WiktorKociuba/protogen-head/assets/mainBoard.png

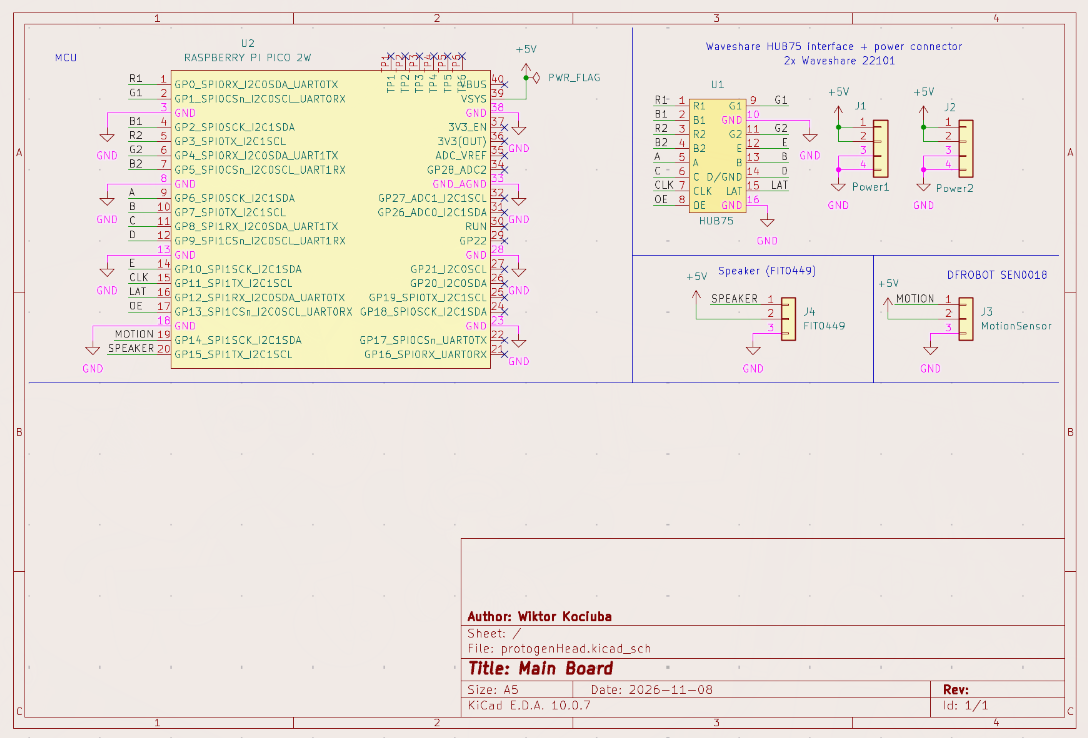
assets/mainBoard.png
