WiktorKociuba/protogen-head/hardware/protogenHead/jlcpcb/production_files/BOM-protogenHead.csv

Comment | Designator | Footprint | LCSC | Quantity
0.1u | C4,C6,C7,C8 | C_0603_1608Metric | C14663 | 4
10k | R1,R2,R3 | R_0603_1608Metric | C25804 | 3
10u | C3 | C_0603_1608Metric | C19702 | 1
1u | C1,C2,C5 | C_0603_1608Metric | C15849 | 3
22 | R4,R5 | R_0603_1608Metric | C23345 | 2
5.1k | R6,R7,R8,R9 | R_0603_1608Metric | C23186 | 4
74AHCT245PW | U5,U6 | TSSOP-20_L6.5-W4.4-P0.65-LS6.4-BL | C54815895 | 2
AP2112K-3.3 | U3 | SOT-23-5 | C23380830 | 1
AltPWR | J10 | AMASS_XT30U-F_1x02_P5.0mm_Vertical | C99102 | 1
Conn_01x01 | J12 | PinSocket_1x01_P2.54mm_Vertical | C49569624 | 1
Conn_02x08_Counter_Clockwise | J13 | PinHeader_2x08_P2.54mm_Vertical | C5383108 | 1
ESP32-S3-MINI-1 | U4 | ESP32-S2-MINI-1 | C2913206 | 1
FIT0449 | J4 | JST_EH_B3B-EH-A_1x03_P2.50mm_Vertical | C160259 | 1
Fan1 | J8 | JST_EH_B2B-EH-A_1x02_P2.50mm_Vertical | C160262 | 1
Fan2 | J9 | JST_EH_B2B-EH-A_1x02_P2.50mm_Vertical | C160262 | 1
HUB75 | U1 | IDC-Header_2x08_P2.54mm_Vertical | C2884532 | 1
Power1 | J1 | TerminalBlock_MaiXu_MX126-5.0-02P_1x02_P5.00mm | C5188434 | 1
Power2 | J2 | TerminalBlock_MaiXu_MX126-5.0-02P_1x02_P5.00mm | C5188434 | 1
PowerExt | J11 | PinHeader_2x04_P2.54mm_Vertical | C5383105 | 1
PowerSup | J7 | USB_C_Receptacle_HRO_TYPE-C-31-M-12 | C165948 | 1
PowerSup+Data | J3 | USB_C_Receptacle_HRO_TYPE-C-31-M-12 | C165948 | 1
TS-1187A-B-A-B | SW3,SW4 | SW-SMD_4P-L5.1-W5.1-P3.70-LS6.5-TL_H1.5 | C318884 | 2
WS2812B | J5,J6 | JST_EH_B3B-EH-A_1x03_P2.50mm_Vertical | C160259 | 2
