WiktorKociuba/protogen-head/hardware/protogenHead/Schematics/protogenHead-B_Cu.pdf

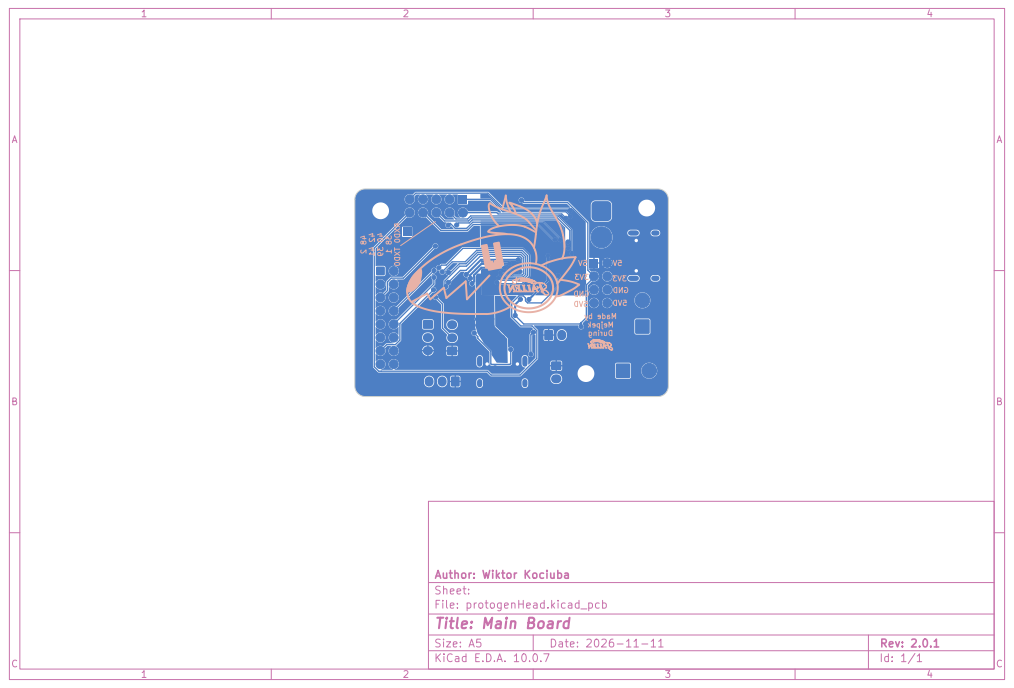
[picture p4: page 1]

Size: A5 | Rev: 2.0.1 | C Date: 2026-11-11
KiCad E.D.A. 10.0.7 | Id: 1/1
