WiktorKociuba/protogen-head/hardware/protogenHead/Schematics/protogenHead-F_Cu.pdf

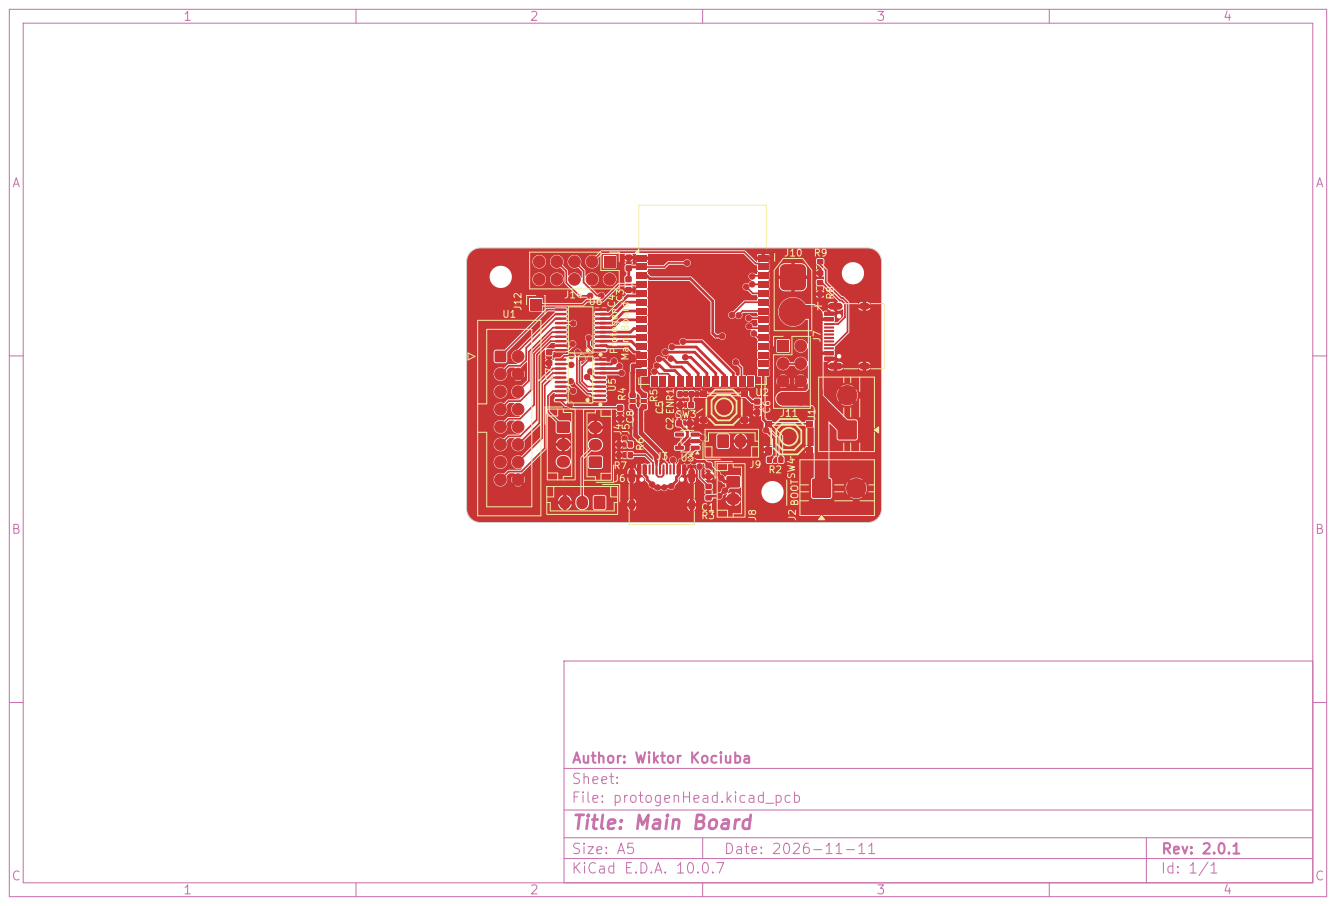
[picture p5: page 1]

Size: A5 | Rev: 2.0.1
KiCad E.D.A. 10.0.7 | Id: 1/1
