WiktorKociuba/protogen-head/hardware/protogenHead/Schematics/protogenHead.pdf

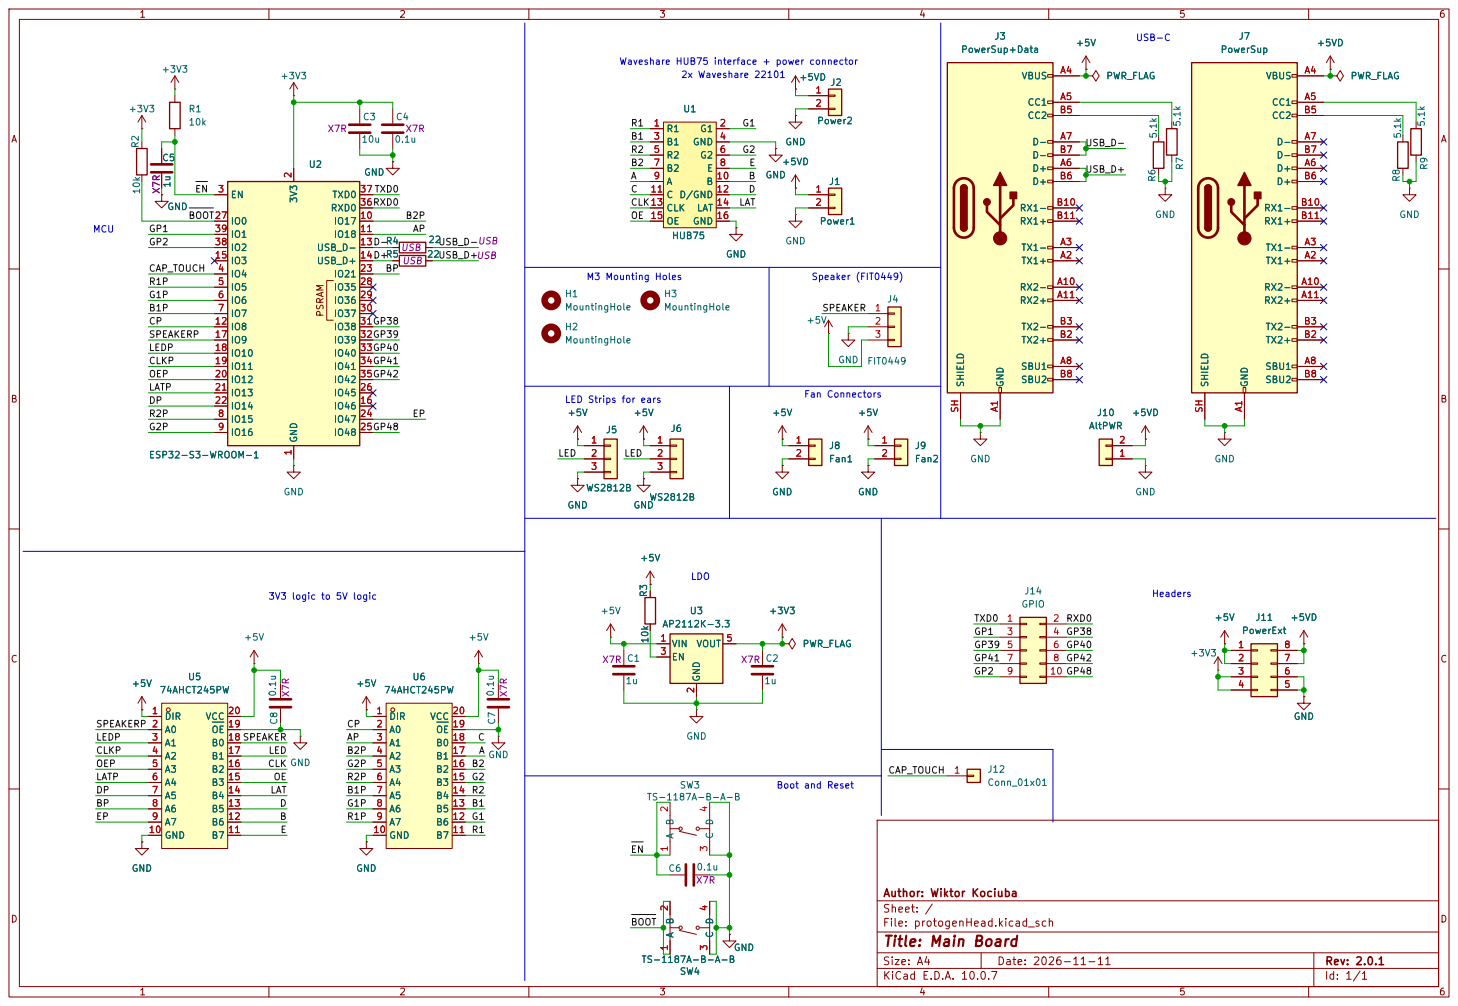
[picture p6: page 1]

Waveshare HUB75 interface + power connector 2x Waveshare 22101 MCU

Size: A4 | Rev: 2.0.1
KiCad E.D.A. 10.0.7 | Id: 1/1
