WiktorKociuba/protogen-head/hardware/backup (rpi)/protogenHead/protogenHead-Edge_Cuts.pdf

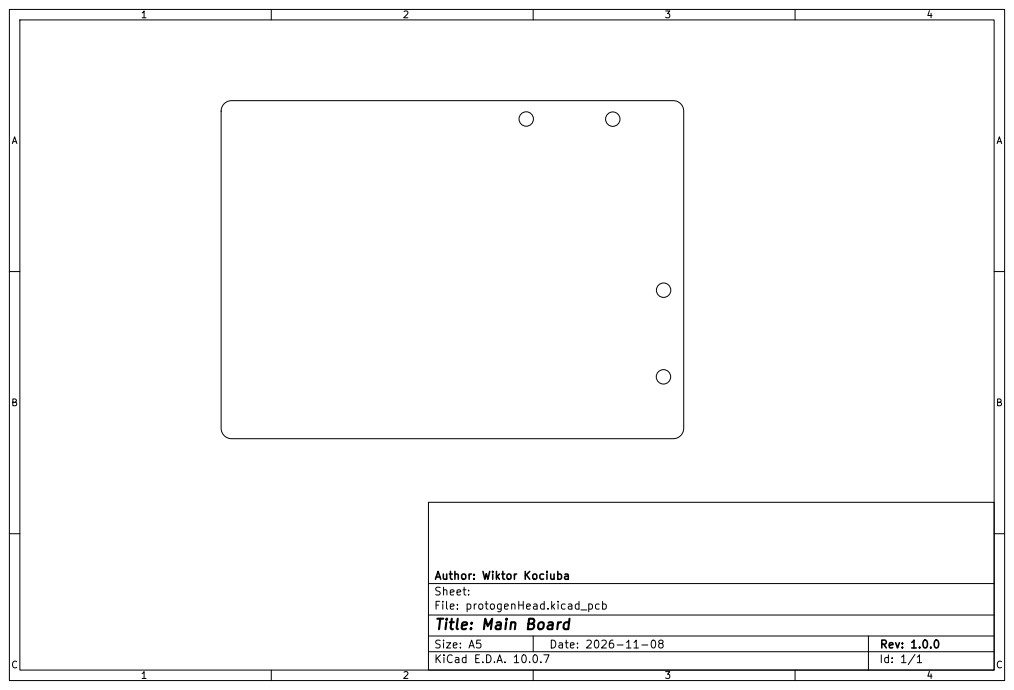
[picture p7: page 1]

Size: A5 | Rev: 1.0.0 | C Date: 2026-11-08
KiCad E.D.A. 10.0.7 | Id: 1/1
