WiktorKociuba/protogen-head/kicad/protogenHead/protogenHead.pdf

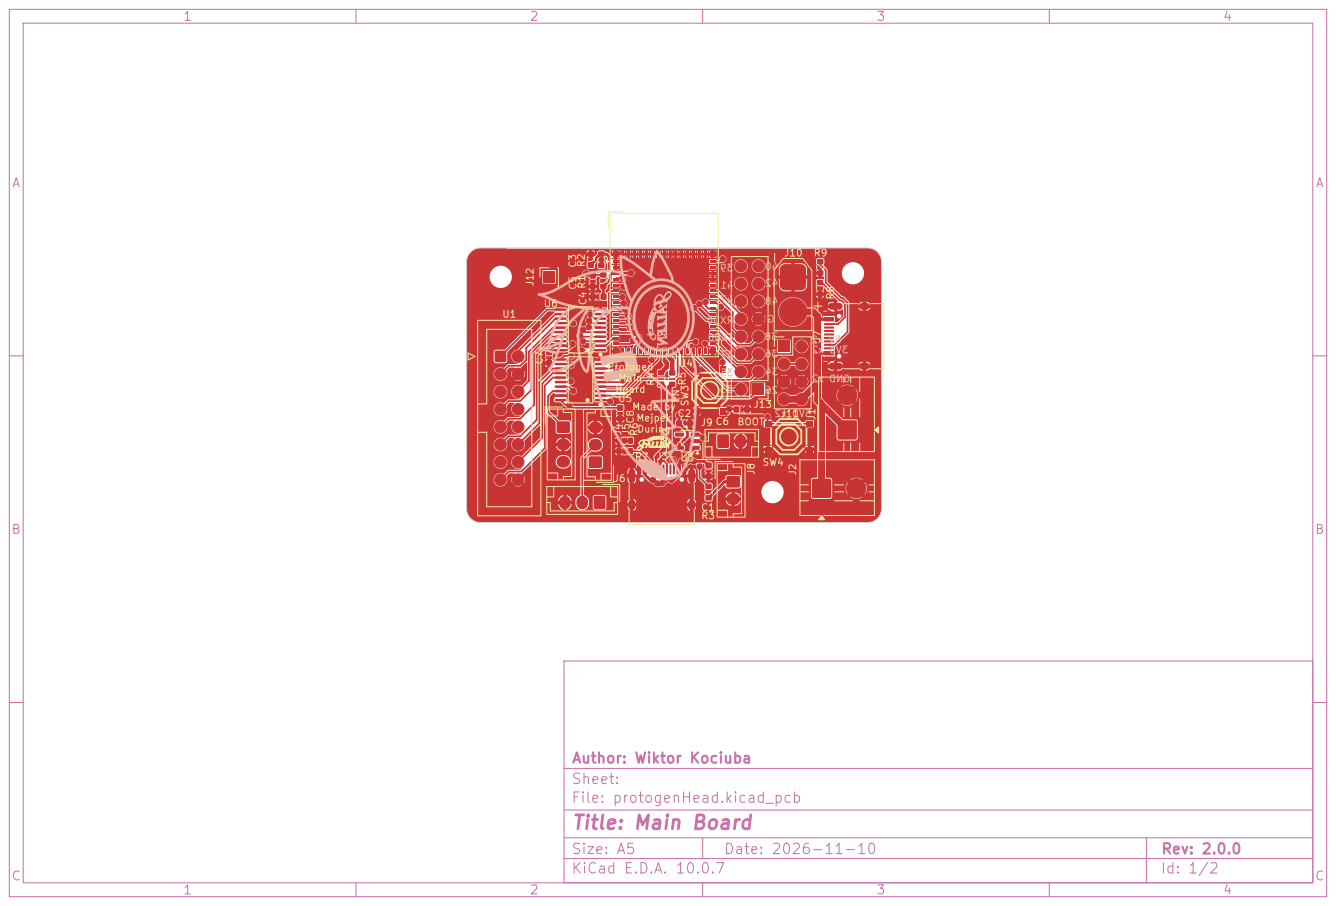
[picture p8: page 1]

Size: A5 | Rev: 2.0.0
KiCad E.D.A. 10.0.7 | Id: 1/2

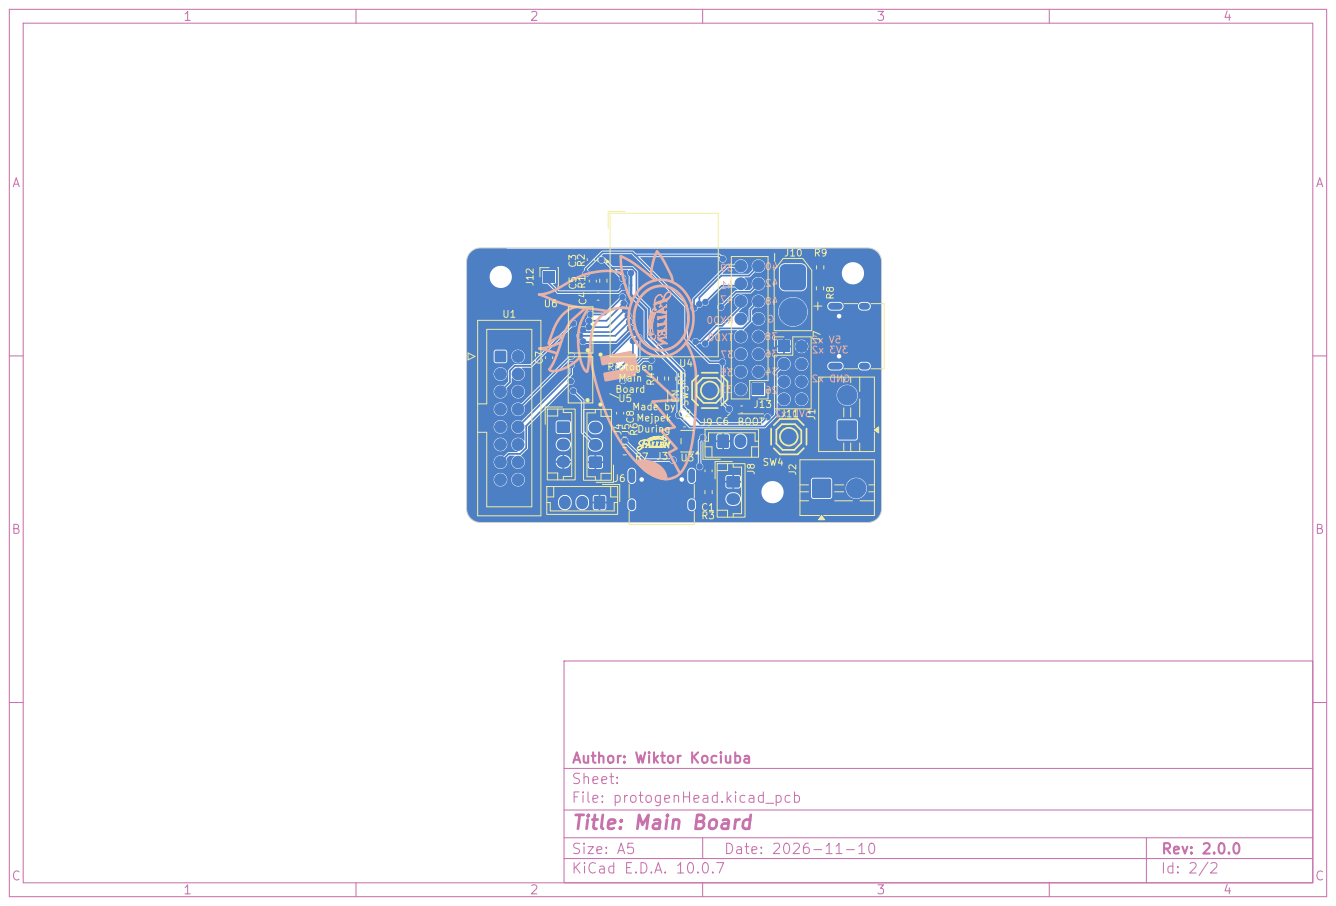
[picture p9: page 2]

Size: A5 | Rev: 2.0.0
KiCad E.D.A. 10.0.7 | Id: 2/2
