WiktorKociuba/protogen-head/kicad/protogenHead/schemat.svg/protogenHead.pdf

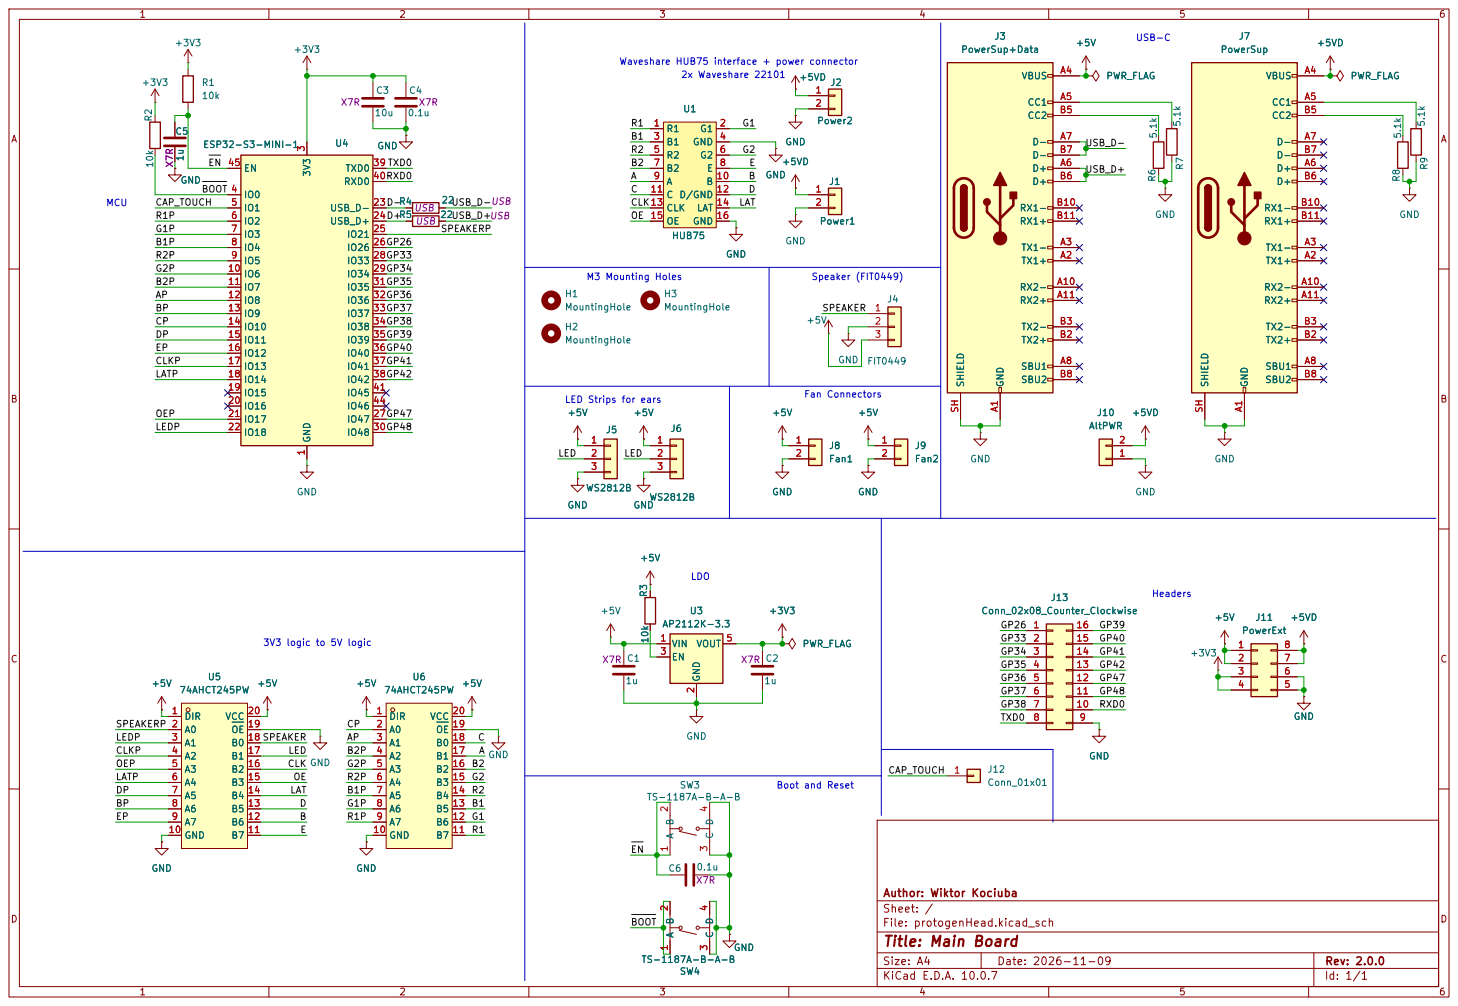
[picture p10: page 1]

Boot and Reset LDO

Size: A4 | Rev: 2.0.0
KiCad E.D.A. 10.0.7 | Id: 1/1
