WiktorKociuba/protogen-head/kicad/backup (rpi)/protogenHead/protogenHead-F_Fab.pdf

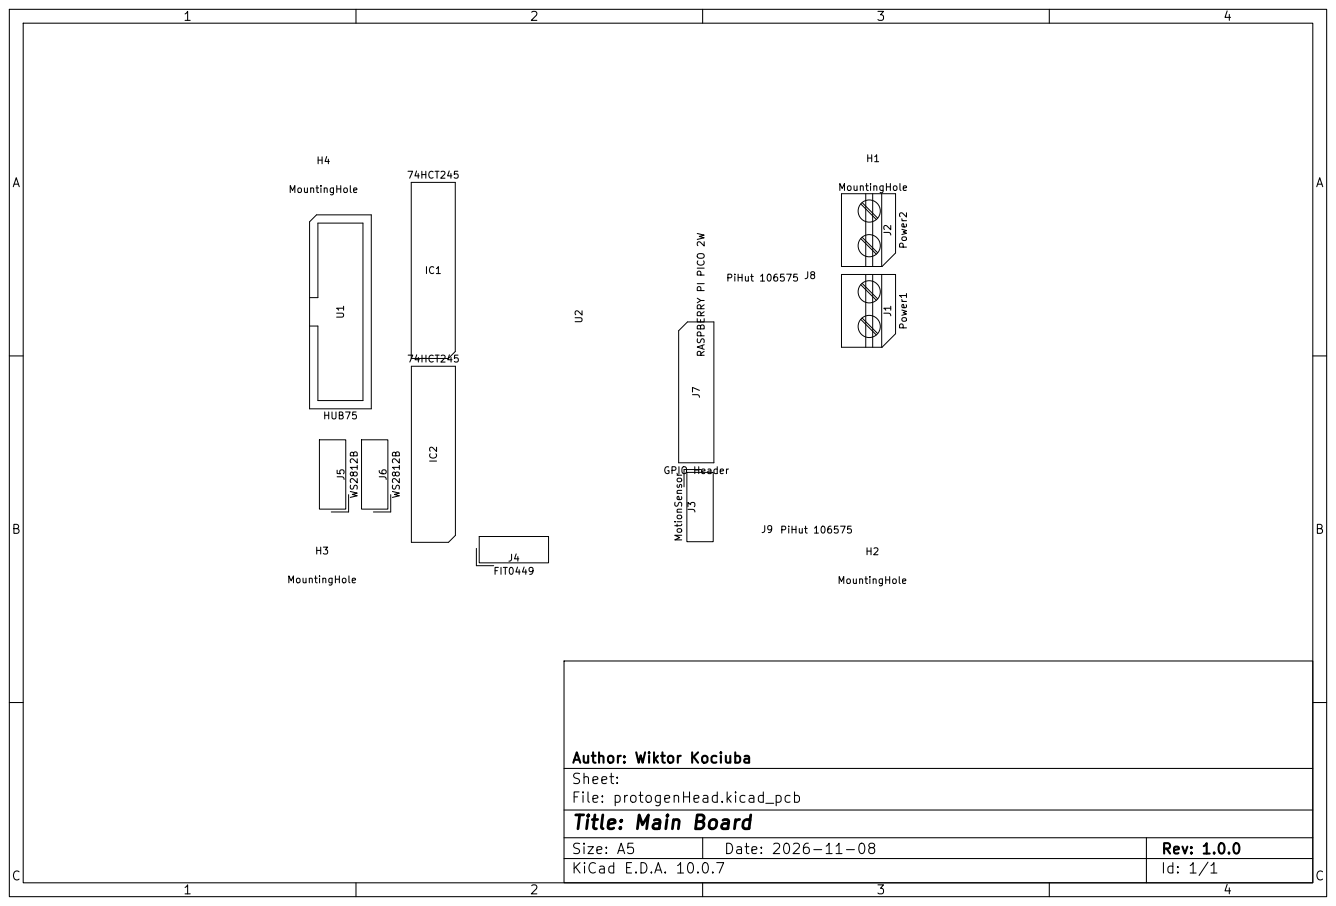
[picture p11: page 1]

Size: A5 | Rev: 1.0.0
KiCad E.D.A. 10.0.7 | Id: 1/1
