WiktorKociuba/protogen-head/hardware/backup (rpi)/protogenHead/protogenHead-B_Cu.pdf

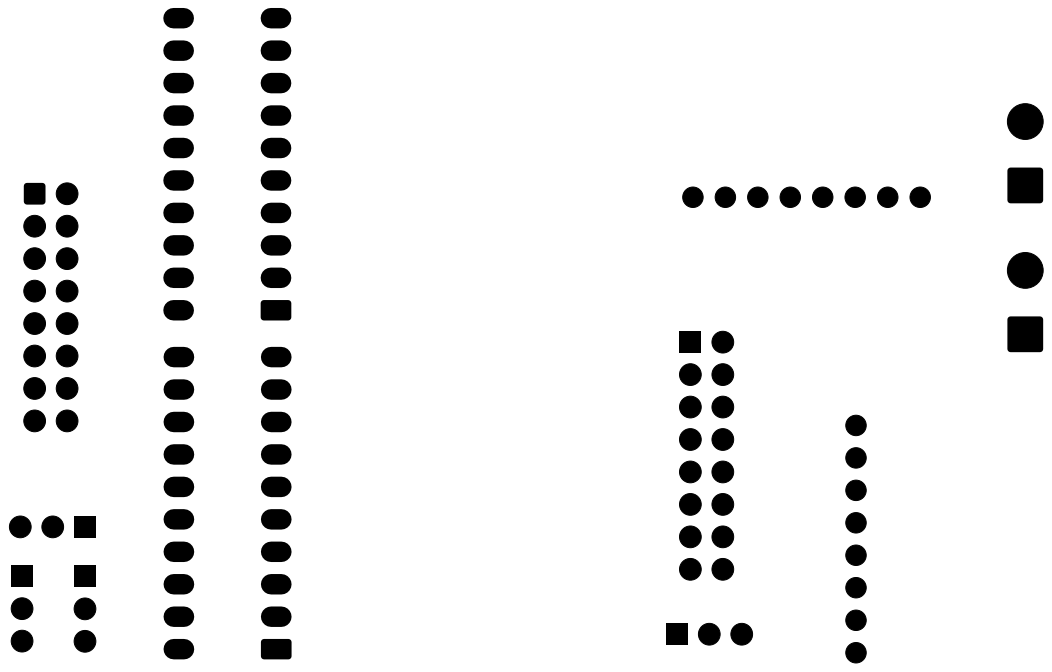
[picture p12: page 1]
