WiktorKociuba/protogen-head/hardware/backup (rpi)/protogenHead/protogenHead-F_Paste.pdf

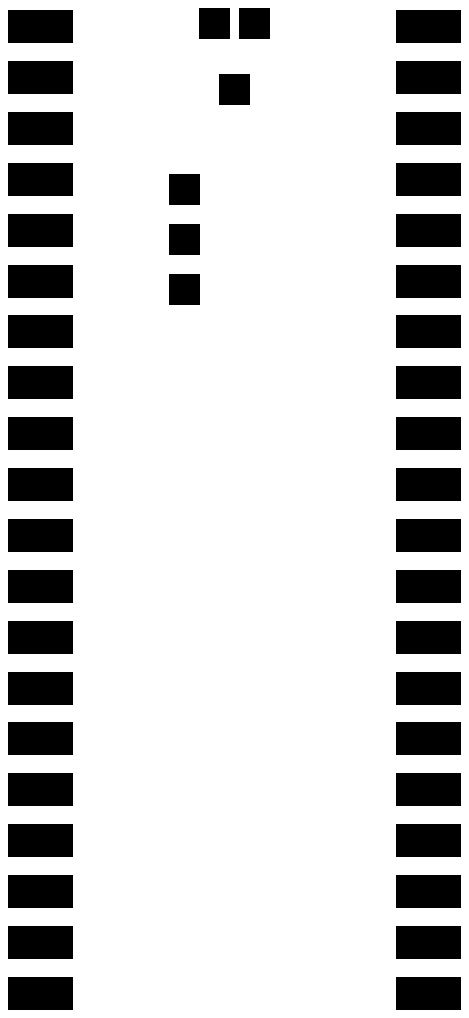
[picture p13: page 1]
