WiktorKociuba/protogen-head/kicad/backup (rpi)/protogenHead/protogenHead-B_Mask.pdf

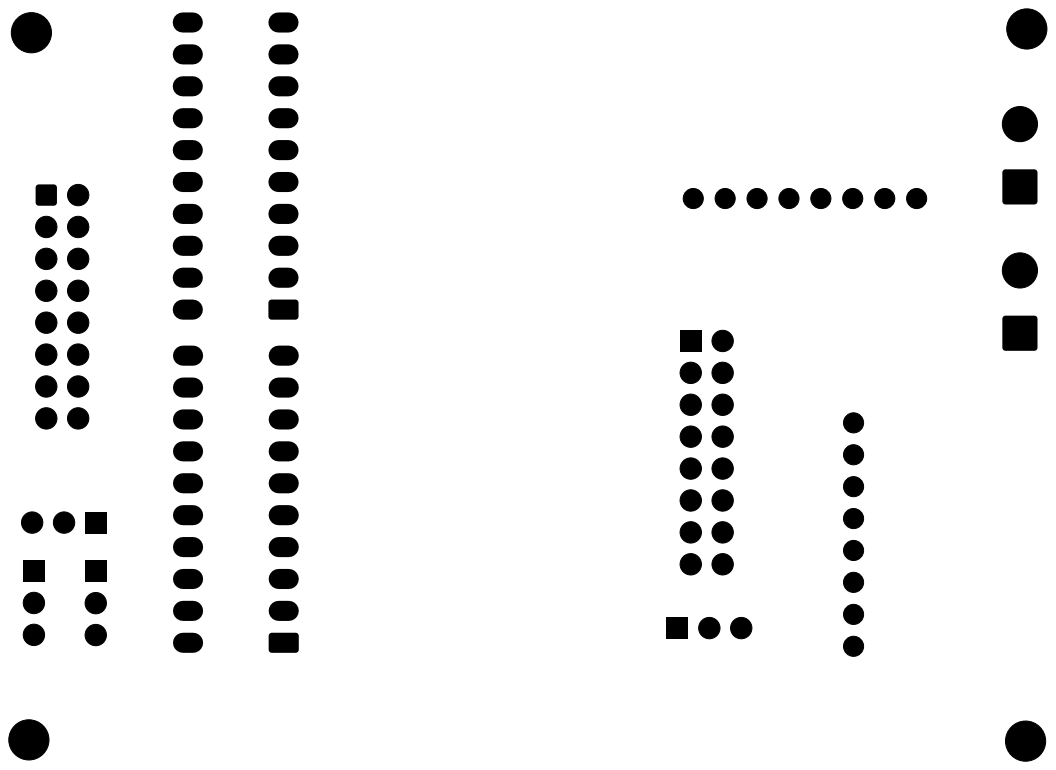
[picture p14: page 1]
