WiktorKociuba/protogen-head/kicad/backup (rpi)/protogenHead/protogenHead-F_Silkscreen.pdf

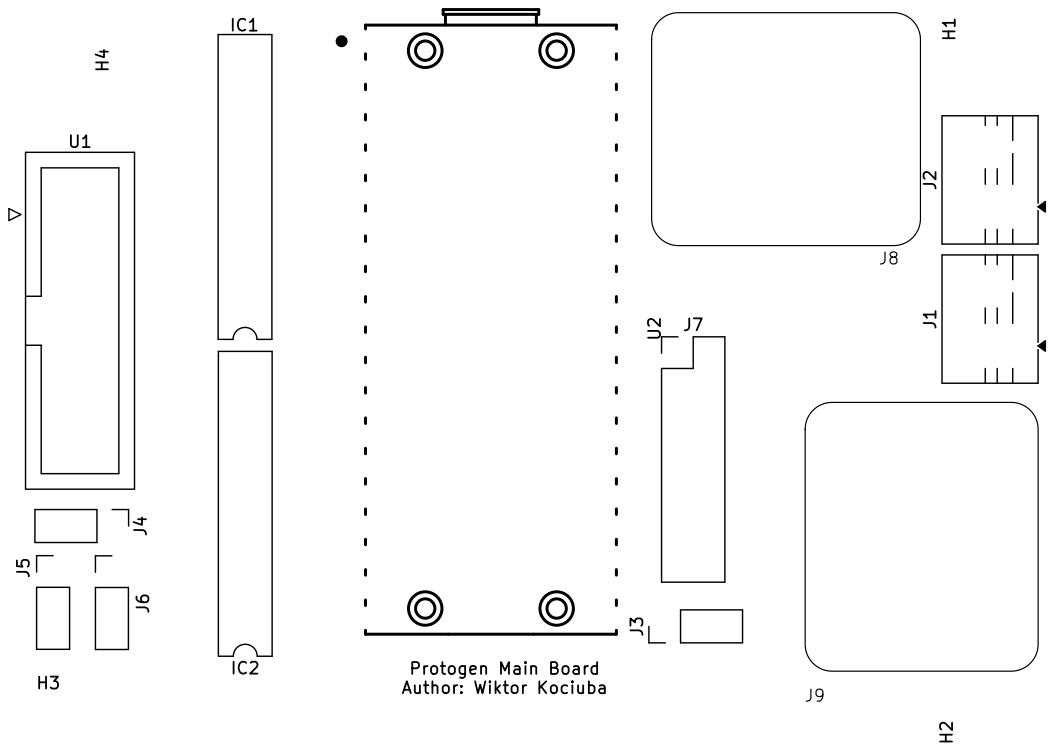
[picture p15: page 1]
