WiktorKociuba/protogen-head/hardware/protogenHead/protogenHead.kicad_pcb

## KiCad design hardware/protogenHead/protogenHead.kicad_pcb (2026-11-12)

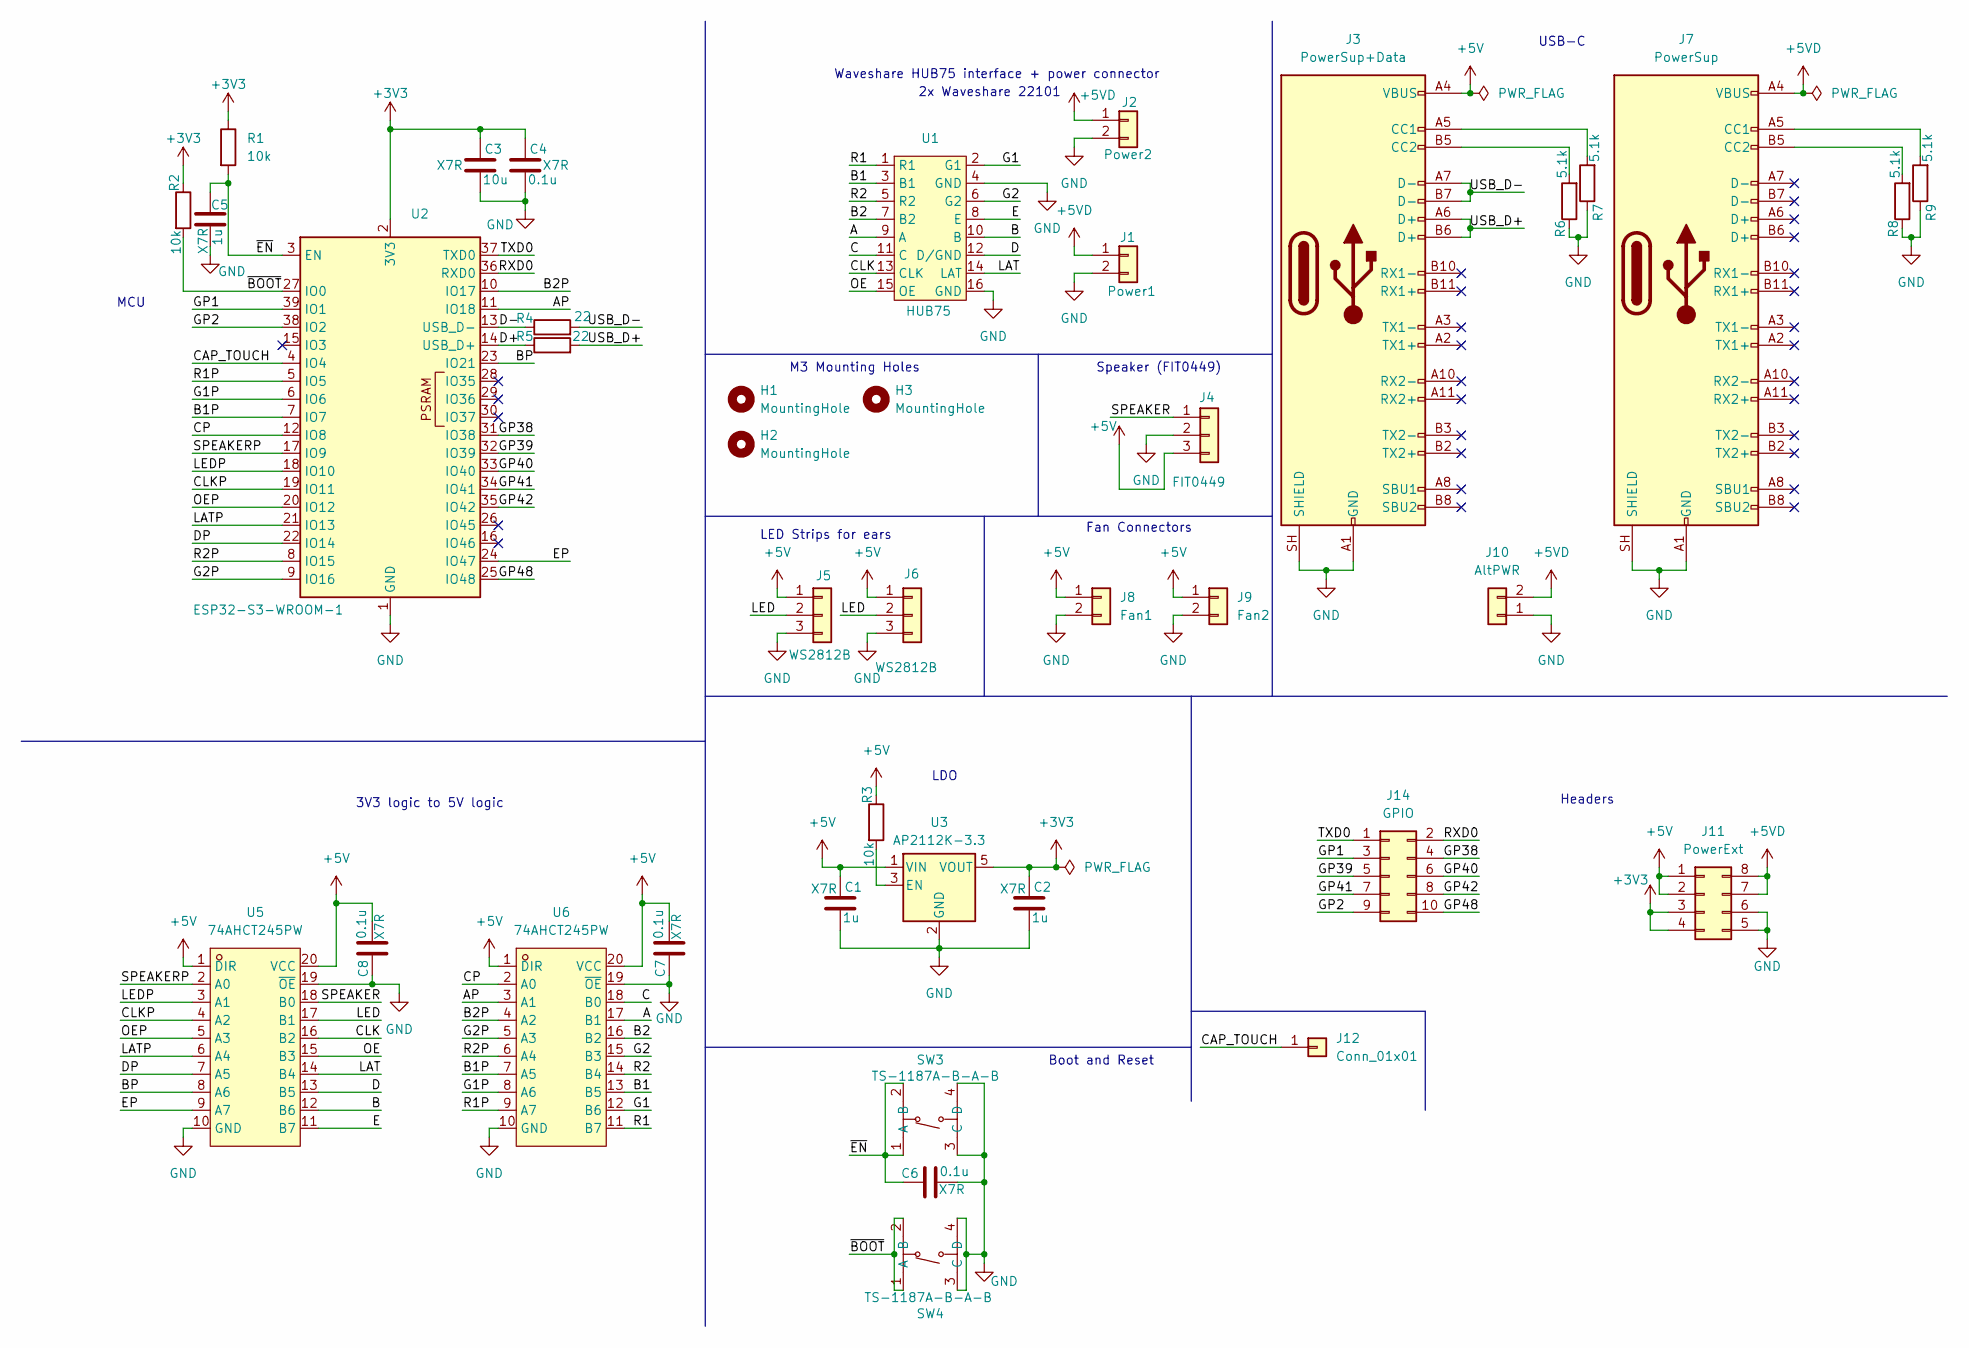
[picture p16: schematic protogenHead.kicad_sch, Main Board]

Parts:
C1, C2, C5: 1u; C_0603_1608Metric
C3: 10u; C_0603_1608Metric
C4, C6, C7, C8: 0.1u; C_0603_1608Metric
H1, H2, H3: MountingHole; MountingHole_3.2mm_M3
J1: Power1; TerminalBlock_MaiXu_MX126-5.0-02P_1x02_P5.00mm
J2: Power2; TerminalBlock_MaiXu_MX126-5.0-02P_1x02_P5.00mm
J3: PowerSup+Data; USB_C_Receptacle_HRO_TYPE-C-31-M-12
J4: FIT0449; JST_EH_B3B-EH-A_1x03_P2.50mm_Vertical
J5, J6: WS2812B; JST_EH_B3B-EH-A_1x03_P2.50mm_Vertical
J7: PowerSup; USB_C_Receptacle_HRO_TYPE-C-31-M-12
J8: Fan1; JST_EH_B2B-EH-A_1x02_P2.50mm_Vertical
J9: Fan2; JST_EH_B2B-EH-A_1x02_P2.50mm_Vertical
J10: AltPWR; AMASS_XT30U-F_1x02_P5.0mm_Vertical
J11: PowerExt; PinHeader_2x04_P2.54mm_Vertical
J12: Conn_01x01; PinSocket_1x01_P2.54mm_Vertical
J14: GPIO; PinHeader_2x05_P2.54mm_Vertical
R1, R2, R3: 10k; R_0603_1608Metric
R4, R5: 22; R_0603_1608Metric
R6, R7, R8, R9: 5.1k; R_0603_1608Metric
SW3, SW4: TS-1187A-B-A-B; SW-SMD_4P-L5.1-W5.1-P3.70-LS6.5-TL_H1.5; MPN TS-1187A-B-A-B; LCSC Part C318884
U1: HUB75; IDC-Header_2x08_P2.54mm_Vertical
U2: ESP32-S3-WROOM-1
U3: AP2112K-3.3; SOT-23-5
U5, U6: 74AHCT245PW; TSSOP-20_L6.5-W4.4-P0.65-LS6.4-BL; MPN 74AHCT245PW; LCSC Part C54815895

Connections:
+3V3: C2.1, C3.1, C4.1, J11.3, J11.4, R1.1, R2.1, U2.2 (3V3), U3.5 (VOUT)
+5V: C1.1, C7.2, C8.2, J3.A4 (VBUS), J3.A9 (VBUS), J3.B4 (VBUS), J3.B9 (VBUS), J4.3, J5.1, J6.1, J8.1, J9.1, J11.1, J11.2, R3.1, U3.1 (VIN), U5.1 (DIR), U5.20 (VCC), U6.1 (DIR), U6.20 (VCC)
+5VD: J1.1, J2.1, J7.A4 (VBUS), J7.A9 (VBUS), J7.B4 (VBUS), J7.B9 (VBUS), J10.2, J11.7, J11.8
/A: U1.9 (A), U6.17 (B1)
/AP: U2.11 (IO18), U6.3 (A1)
/B: U1.10 (B), U5.12 (B6)
/B1: U1.3 (B1), U6.13 (B5)
/B1P: U2.7 (IO7), U6.7 (A5)
/B2: U1.7 (B2), U6.16 (B2)
/B2P: U2.10 (IO17), U6.4 (A2)
/BP: U2.23 (IO21), U5.8 (A6)
/C: U1.11 (C), U6.18 (B0)
/CAP_TOUCH: J12.1 (Pin_1_1), U2.4 (IO4)
/CLK: U1.13 (CLK), U5.16 (B2)
/CLKP: U2.19 (IO11), U5.4 (A2)
/CP: U2.12 (IO8), U6.2 (A0)
/D: U1.12 (D/GND), U5.13 (B5)
/D+: R5.1, U2.14 (USB_D+)
/D-: R4.1, U2.13 (USB_D-)
/DP: U2.22 (IO14), U5.7 (A5)
/E: U1.8 (E), U5.11 (B7)
/EP: U2.24 (IO47), U5.9 (A7)
/G1: U1.2 (G1), U6.12 (B6)
/G1P: U2.6 (IO6), U6.8 (A6)
/G2: U1.6 (G2), U6.15 (B3)
/G2P: U2.9 (IO16), U6.5 (A3)
/GP1: J14.3, U2.39 (IO1)
/GP2: J14.9, U2.38 (IO2)
/GP38: J14.4, U2.31 (IO38)
/GP39: J14.5, U2.32 (IO39)
/GP40: J14.6, U2.33 (IO40)
/GP41: J14.7, U2.34 (IO41)
/GP42: J14.8, U2.35 (IO42)
/GP48: J14.10, U2.25 (IO48)
/LAT: U1.14 (LAT), U5.14 (B4)
/LATP: U2.21 (IO13), U5.6 (A4)
/LED: J5.2, J6.2, U5.17 (B1)
/LEDP: U2.18 (IO10), U5.3 (A1)
/OE: U1.15 (OE), U5.15 (B3)
/OEP: U2.20 (IO12), U5.5 (A3)
/R1: U1.1 (R1), U6.11 (B7)
/R1P: U2.5 (IO5), U6.9 (A7)
/R2: U1.5 (R2), U6.14 (B4)
/R2P: U2.8 (IO15), U6.6 (A4)
/RXD0: J14.2, U2.36 (RXD0)
/SPEAKER: J4.1, U5.18 (B0)
/SPEAKERP: U2.17 (IO9), U5.2 (A0)
/TXD0: J14.1, U2.37 (TXD0)
/USB_D+: J3.A6 (D+), J3.B6 (D+), R5.2
/USB_D-: J3.A7 (D-), J3.B7 (D-), R4.2
/~BOOT: R2.2, SW4.1 (A), SW4.2 (B), U2.27 (IO0)
/~EN: C5.1, C6.1, R1.2, SW3.1 (A), SW3.2 (B), U2.3 (EN)
GND: C1.2, C2.2, C3.2, C4.2, C5.2, C6.2, C7.1, C8.1, J1.2, J2.2, J3.A1 (GND), J3.A12 (GND), J3.B1 (GND), J3.B12 (GND), J3.SH (SHIELD), J4.2, J5.3, J6.3, J7.A1 (GND), J7.A12 (GND), J7.B1 (GND), J7.B12 (GND), J7.SH (SHIELD), J8.2, J9.2, J10.1, J11.5, J11.6, R6.1, R7.1, R8.1, R9.1, SW3.3 (C), SW3.4 (D), SW4.3 (C), SW4.4 (D), U1.4 (GND), U1.16 (GND), U2.1 (GND), U2.40 (GND), U2.41 (GND), U3.2 (GND), U5.10 (GND), U5.19 (~OE), U6.10 (GND), U6.19 (~OE)
unnamed: J3.A5 (CC1), R7.2
unnamed: J3.B5 (CC2), R6.2
unnamed: J7.A5 (CC1), R9.2
unnamed: J7.B5 (CC2), R8.2
unnamed: R3.2, U3.3 (EN)

Notes on the sheet:
3V3 logic to 5V logic
Boot and Reset
M3 Mounting Holes
USB-C
Fan Connectors
Speaker (FIT0449)
LDO
Waveshare HUB75 interface + power connector
LED Strips for ears
2x Waveshare 22101
Headers
MCU

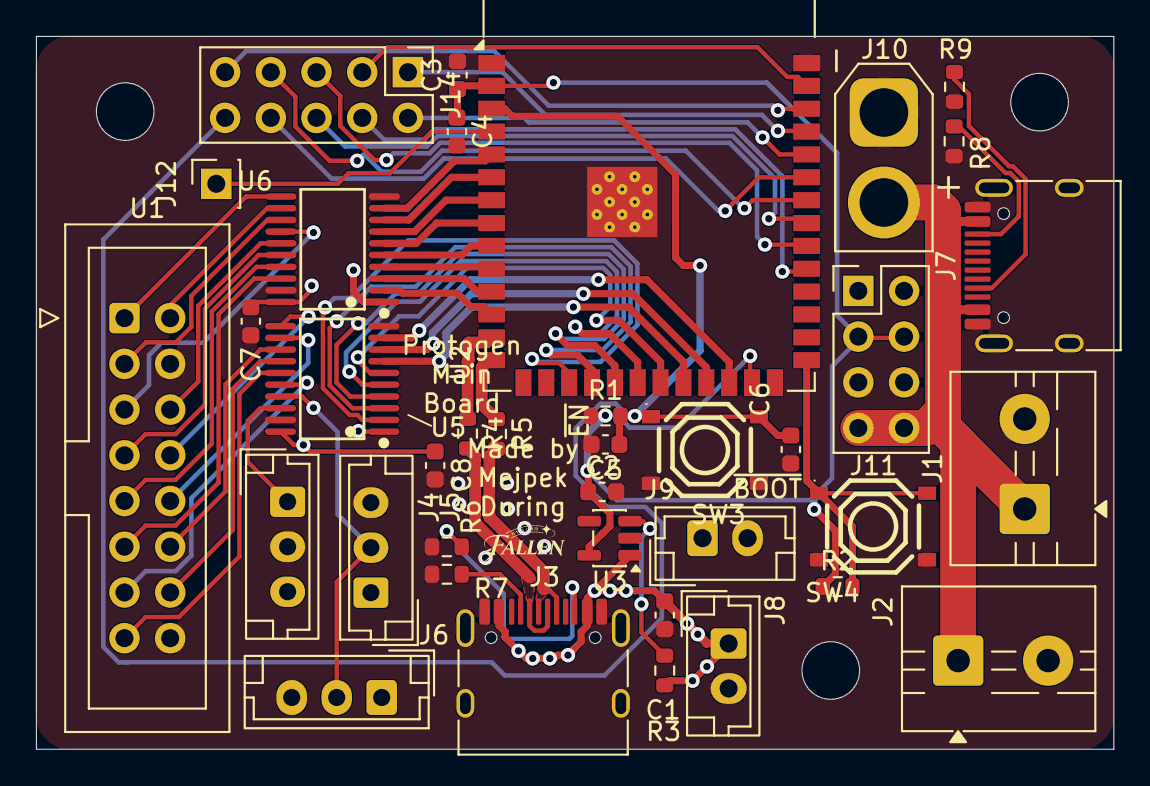
[picture p17: board hardware/protogenHead/protogenHead.kicad_pcb from above]

Board: 2 copper layers, 59.9 x 39.6 mm, 40 parts (0 on the bottom side), 58 nets.
