WiktorKociuba/protogen-head/kicad/backup (rpi)/protogenHead/protogenHead.kicad_pcb

## KiCad design kicad/backup (rpi)/protogenHead/protogenHead.kicad_pcb (2026-11-09)

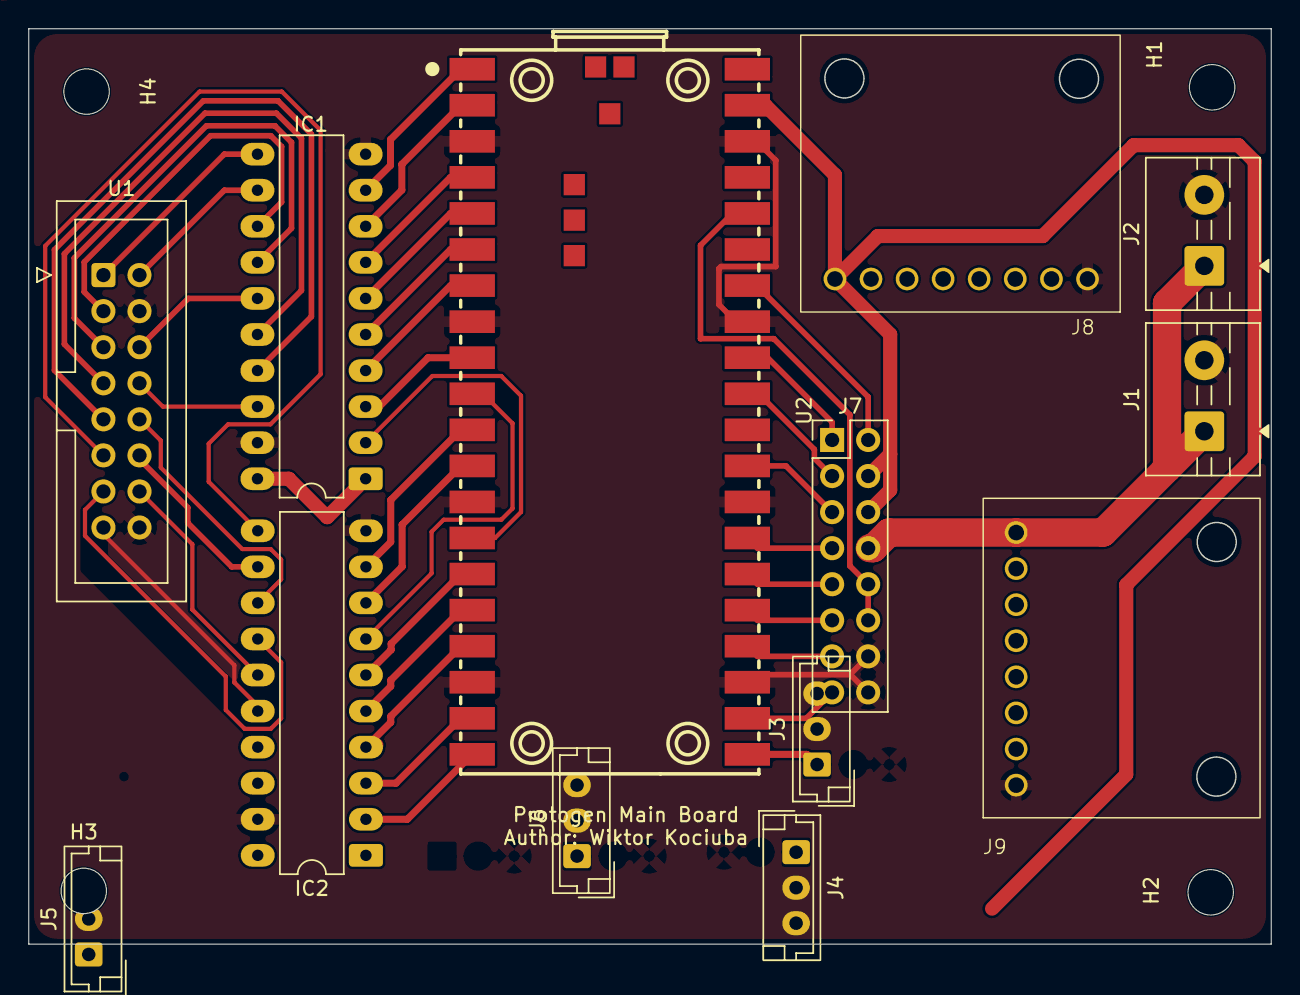
[picture p18: board kicad/backup (rpi)/protogenHead/protogenHead.kicad_pcb from above]

Board: 2 copper layers, 87.5 x 64.5 mm, 17 parts (0 on the bottom side), 46 nets.

Parts:
H1, H2, H3, H4: MountingHole; MountingHole_3.2mm_M3
IC1, IC2: 74HCT245; DIP-20_W7.62mm_LongPads
J1: Power1; TerminalBlock_MaiXu_MX126-5.0-02P_1x02_P5.00mm
J2: Power2; TerminalBlock_MaiXu_MX126-5.0-02P_1x02_P5.00mm
J3: MotionSensor; JST_EH_B3B-EH-A_1x03_P2.50mm_Vertical
J4: FIT0449; JST_EH_B3B-EH-A_1x03_P2.50mm_Vertical
J5, J6: WS2812B; JST_EH_B3B-EH-A_1x03_P2.50mm_Vertical
J7: GPIO Header; PinHeader_2x08_P2.54mm_Vertical
J8, J9: PiHut 106575; PiHut USB-C
U1: HUB75; IDC-Header_2x08_P2.54mm_Vertical
U2: RASPBERRY PI PICO 2W; Pi Pico 2W

Connections:
+3V3: J3.2, J7.10, J7.12, U2.36 (3V3(OUT))
+5V: IC1.1 (DIR), IC1.20 (VCC), IC2.1 (DIR), IC2.20 (VCC), J4.2, J5.1, J6.1, J7.4, J7.6, J8.A4 (VBUS), U2.39 (VSYS)
+5VD: J1.1, J2.1, J7.8, J9.A4 (VBUS)
/A: IC1.17 (B2), U1.9 (A)
/AP: IC1.3 (A2), U2.9 (GP6_SPI0SCK_I2C1SDA)
/B: IC2.13 (B6), U1.10 (B)
/B1: IC1.13 (B6), U1.3 (B1)
/B1P: IC1.7 (A6), U2.4 (GP2_SPI0SCK_I2C1SDA)
/B2: IC1.16 (B3), U1.7 (B2)
/B2P: IC1.4 (A3), U2.7 (GP5_SPI0CSn_I2C0SCL_UART1RX)
/BP: IC2.7 (A6), U2.10 (GP7_SPI0TX_I2C1SCL)
/C: IC2.11 (B8), U1.11 (C)
/CLK: IC2.14 (B5), U1.13 (CLK)
/CLKP: IC2.6 (A5), U2.15 (GP11_SPI1TX_I2C1SCL)
/CP: IC2.9 (A8), U2.11 (GP8_SPI1RX_I2C0SDA_UART1TX)
/D: IC2.12 (B7), U1.12 (D/GND)
/DP: IC2.8 (A7), U2.12 (GP9_SPI1CSn_I2C0SCL_UART1RX)
/E: IC1.18 (B1), U1.8 (E)
/EP: IC1.2 (A1), U2.14 (GP10_SPI1SCK_I2C1SDA)
/G1: IC1.12 (B7), U1.2 (G1)
/G1P: IC1.8 (A7), U2.2 (GP1_SPI0CSn_I2C0SCL_UART0RX)
/G2: IC1.15 (B4), U1.6 (G2)
/G2P: IC1.5 (A4), U2.6 (GP4_SPI0RX_I2C0SDA_UART1TX)
/GP17: J7.15, U2.22 (GP17_SPI0CSn_UART0TX)
/GP18: J7.13, U2.24 (GP18_SPI0SCK_I2C1SDA)
/GP19: J7.11, U2.25 (GP19_SPI0TX_I2C1SCL)
/GP20: J7.9, U2.26 (GP20_I2C0SDA)
/GP21: J7.7, U2.27 (GP21_I2C0SCL)
/GP22: J7.5, U2.29 (GP22)
/GP26: J7.3, U2.31 (GP26_ADC0_I2C1SDA)
/GP27: J7.1, U2.32 (GP27_ADC1_I2C1SCL)
/GP28: J7.2, U2.34 (GP28_ADC2)
/LAT: IC2.15 (B4), U1.14 (LAT)
/LATP: IC2.5 (A4), U2.16 (GP12_SPI1RX_I2C0SDA_UART0TX)
/LED: IC2.17 (B2), J5.2, J6.2
/LEDP: IC2.3 (A2), U2.19 (GP14_SPI1SCK_I2C1SDA)
/MOTION: J3.1, U2.21 (GP16_SPI0RX_UART0RX)
/OE: IC2.16 (B3), U1.15 (OE)
/OEP: IC2.4 (A3), U2.17 (GP13_SPI1CSn_I2C0SCL_UART0RX)
/R1: IC1.11 (B8), U1.1 (R1)
/R1P: IC1.9 (A8), U2.1 (GP0_SPI0RX_I2C0SDA_UART0TX)
/R2: IC1.14 (B5), U1.5 (R2)
/R2P: IC1.6 (A5), U2.5 (GP3_SPI0TX_I2C1SCL)
/SPEAKER: IC2.18 (B1), J4.1
/SPEAKERP: IC2.2 (A1), U2.20 (GP15_SPI1TX_I2C1SCL)
GND: IC1.10 (GND), IC1.19 (~OE), IC2.10 (GND), IC2.19 (~OE), J1.2, J2.2, J3.3, J4.3, J5.3, J6.3, J7.14, J7.16, J8.A1 (GND), J9.A1 (GND), U1.4 (GND), U1.16 (GND), U2.3 (GND), U2.8 (GND), U2.13 (GND), U2.18 (GND), U2.23 (GND), U2.28 (GND), U2.33 (GND_AGND), U2.38 (GND)
