WiktorKociuba/protogen-head/(commit log)

2026-11-07 Created first iteration of the main board schematic
2026-11-07 Updated readme schematic
2026-11-08 Updated the schematic with correct components, added the logic voltage level switching and assigned footprints
2026-11-09 Finished Pico version
2026-11-09 Redesigned the schematic and made the outline of the PCB
2026-11-11 Finished te 2.0.0 board
2026-11-12 Changed the MCU to ESP32-S3-WROOM-1
2026-11-13 Added software that interfeces LED Matrixes, led strips and speaker and capacitive sensor
